david-schoe/mcmb/root_mcmb_pcb_files/root_pcb_3d_models/root_usr_es1_ethernet_tiago_silva/USR-ES1 Ethernet Module.PNG

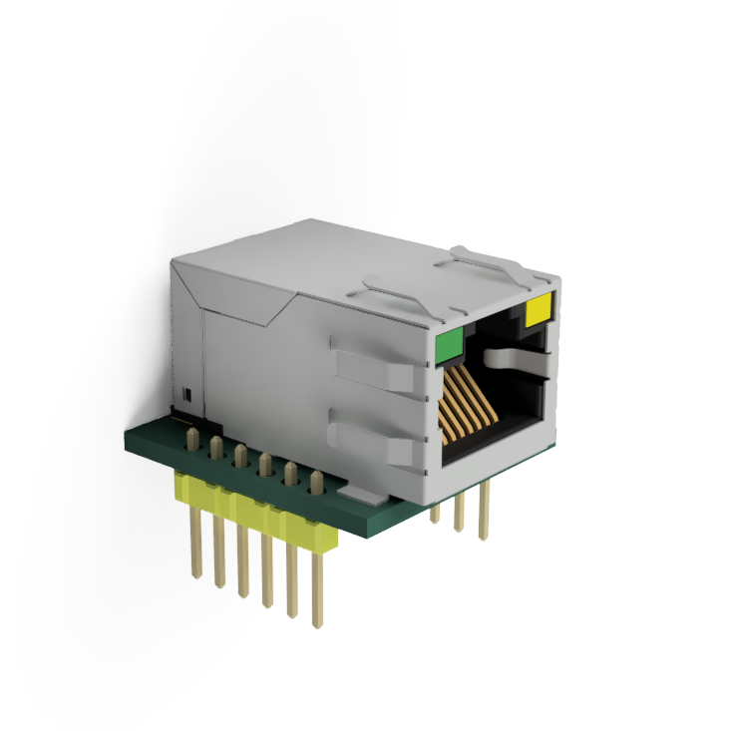
root_mcmb_pcb_files/root_pcb_3d_models/root_usr_es1_ethernet_tiago_silva/USR-ES1 Ethernet Module.PNG
