david-schoe/mcmb/root_mcmb_pcb_files/root_pcb_3d_models/root_enclosure/din_clip.stp

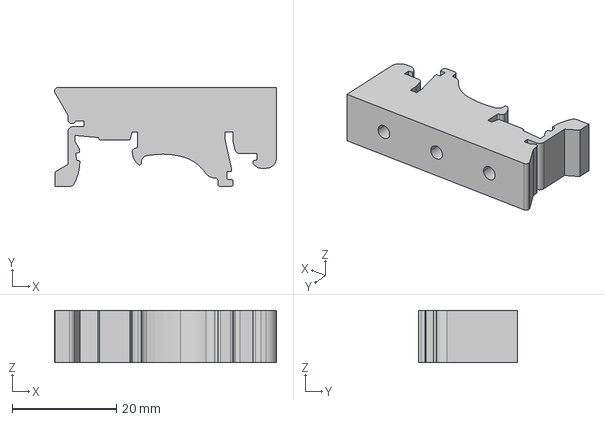
[picture p2: CAD file, 2025-05-01]
root_mcmb_pcb_files/root_pcb_3d_models/root_enclosure/din_clip.stp
42.6 x 19.0 x 10.0 mm
