david-schoe/mcmb/root_mcmb_pcb_files/root_pcb_3d_models/root_esp32_ch340_pennel_patrice/esp32_wroom_32D_kitV1_wph.step

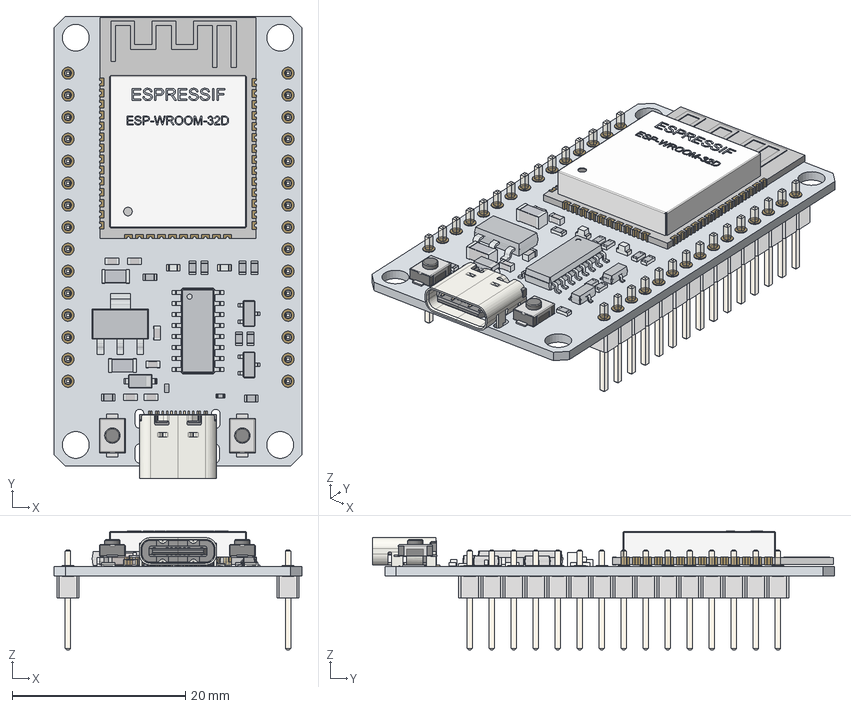
[picture p3: CAD file, 2025-05-01]
root_mcmb_pcb_files/root_pcb_3d_models/root_esp32_ch340_pennel_patrice/esp32_wroom_32D_kitV1_wph.step
28.6 x 53.3 x 13.7 mm
PCB
SOIC_16_39x99mm_P127mm
SOT_223
USB_C_Receptacle_16P_TopMnt_Horizontal_GCT_USB4105-xx-A
USB_C_Receptacle_16P_TopMnt_Horizontal_GCT_USB4105-xx-A001
USB_C_Receptacle_16P_TopMnt_Horizontal_GCT_USB4105-xx-A002
USB_C_Receptacle_16P_TopMnt_Horizontal_GCT_USB4105-xx-A003
USB_C_Receptacle_16P_TopMnt_Horizontal_GCT_USB4105-xx-A004
USB_C_Receptacle_16P_TopMnt_Horizontal_GCT_USB4105-xx-A005
USB_C_Receptacle_16P_TopMnt_Horizontal_GCT_USB4105-xx-A006
USB_C_Receptacle_16P_TopMnt_Horizontal_GCT_USB4105-xx-A007
USB_C_Receptacle_16P_TopMnt_Horizontal_GCT_USB4105-xx-A008
USB_C_Receptacle_16P_TopMnt_Horizontal_GCT_USB4105-xx-A009
USB_C_Receptacle_16P_TopMnt_Horizontal_GCT_USB4105-xx-A010
USB_C_Receptacle_16P_TopMnt_Horizontal_GCT_USB4105-xx-A011
USB_C_Receptacle_16P_TopMnt_Horizontal_GCT_USB4105-xx-A012
USB_C_Receptacle_16P_TopMnt_Horizontal_GCT_USB4105-xx-A013
USB_C_Receptacle_16P_TopMnt_Horizontal_GCT_USB4105-xx-A014
USB_C_Receptacle_16P_TopMnt_Horizontal_GCT_USB4105-xx-A015
USB_C_Receptacle_16P_TopMnt_Horizontal_GCT_USB4105-xx-A016
USB_C_Receptacle_16P_TopMnt_Horizontal_GCT_USB4105-xx-A017
USB_C_Receptacle_16P_TopMnt_Horizontal_GCT_USB4105-xx-A018
USB_C_Receptacle_16P_TopMnt_Horizontal_GCT_USB4105-xx-A019
USB_C_Receptacle_16P_TopMnt_Horizontal_GCT_USB4105-xx-A020
USB_C_Receptacle_16P_TopMnt_Horizontal_GCT_USB4105-xx-A021
USB_C_Receptacle_16P_TopMnt_Horizontal_GCT_USB4105-xx-A022
USB_C_Receptacle_16P_TopMnt_Horizontal_GCT_USB4105-xx-A023
USB_C_Receptacle_16P_TopMnt_Horizontal_GCT_USB4105-xx-A024
USB_C_Receptacle_16P_TopMnt_Horizontal_GCT_USB4105-xx-A025
USB_C_Receptacle_16P_TopMnt_Horizontal_GCT_USB4105-xx-A026
USB_C_Receptacle_16P_TopMnt_Horizontal_GCT_USB4105-xx-A027
USB_C_Receptacle_16P_TopMnt_Horizontal_GCT_USB4105-xx-A028
USB_C_Receptacle_16P_TopMnt_Horizontal_GCT_USB4105-xx-A029
USB_C_Receptacle_16P_TopMnt_Horizontal_GCT_USB4105-xx-A030
USB_C_Receptacle_16P_TopMnt_Horizontal_GCT_USB4105-xx-A031
USB_C_Receptacle_16P_TopMnt_Horizontal_GCT_USB4105-xx-A032
USB_C_Receptacle_16P_TopMnt_Horizontal_GCT_USB4105-xx-A033
USB_C_Receptacle_16P_TopMnt_Horizontal_GCT_USB4105-xx-A034
USB_C_Receptacle_16P_TopMnt_Horizontal_GCT_USB4105-xx-A035
LED_0603_D2
LED_0603_PWR
SOT_23_1
SOT_23_002
D_SOD_123
R_0603_
R_0603_001
R_0603_002
R_0603_003
R_0603_004
R_0603_005
R_0603_006
R_0603_007
R_0402_001
R_0402_002
R_0603_008
C_0603_
C_0603_001
C_0603_002
C_0603_003
C_0603_004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
