david-schoe/mcmb/root_mcmb_pcb_files/root_pcb_3d_models/root_power_supply/TMH2405S.step

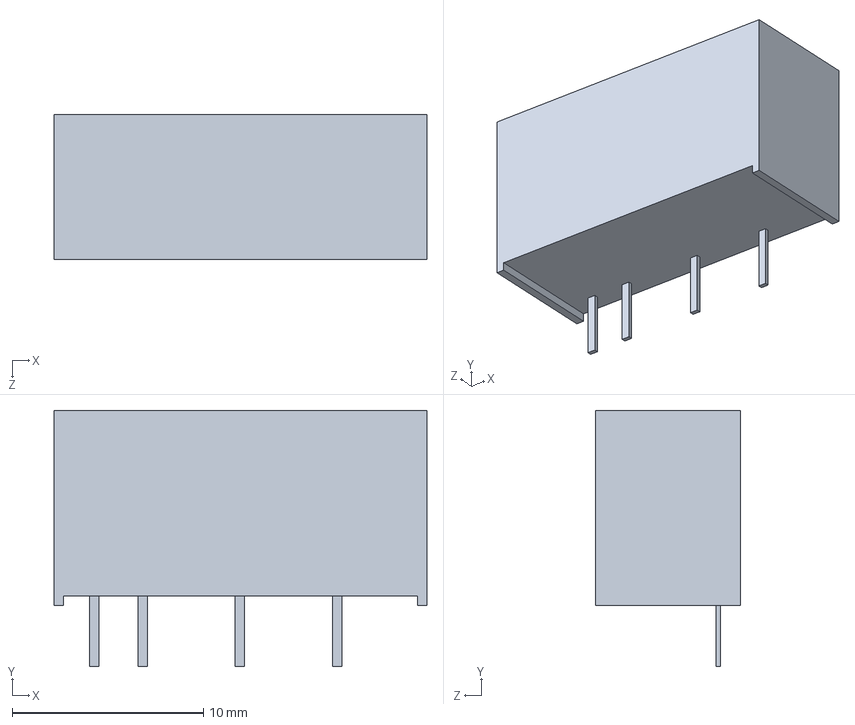
[picture p4: CAD file, 2025-05-01]
root_mcmb_pcb_files/root_pcb_3d_models/root_power_supply/TMH2405S.step
19.5 x 13.4 x 7.60 mm
