david-schoe/mcmb/root_mcmb_pcb_files/root_pcb_3d_models/root_terminals/header+connector.step

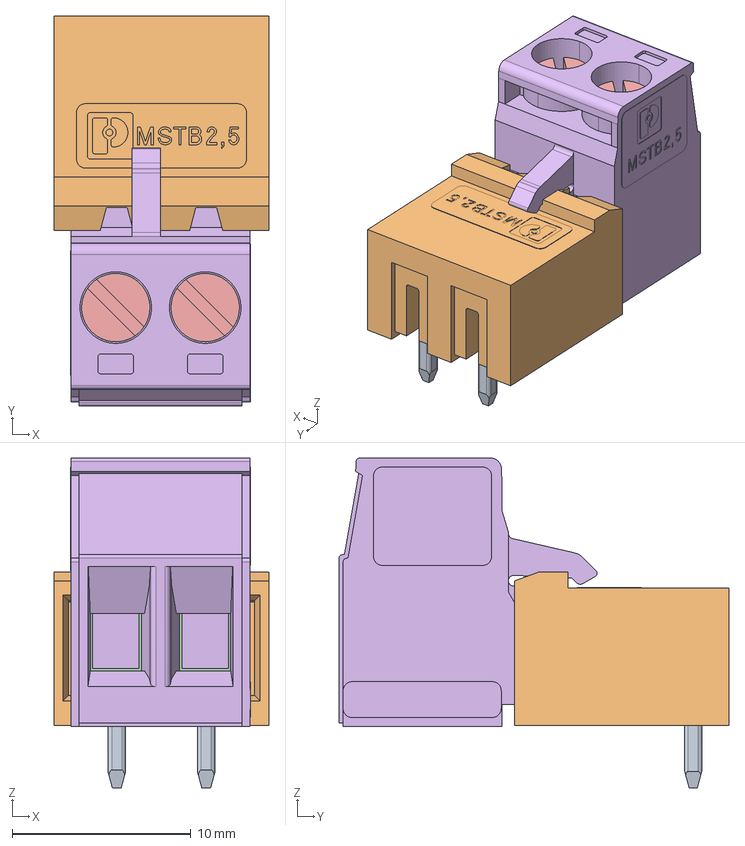
[picture p5: CAD file, 2025-05-01]
root_mcmb_pcb_files/root_pcb_3d_models/root_terminals/header+connector.step
12.0 x 21.8 x 18.4 mm
