david-schoe/mcmb/root_mcmb_pcb_files/root_pcb_3d_models/root_terminals/header/header.FCStd

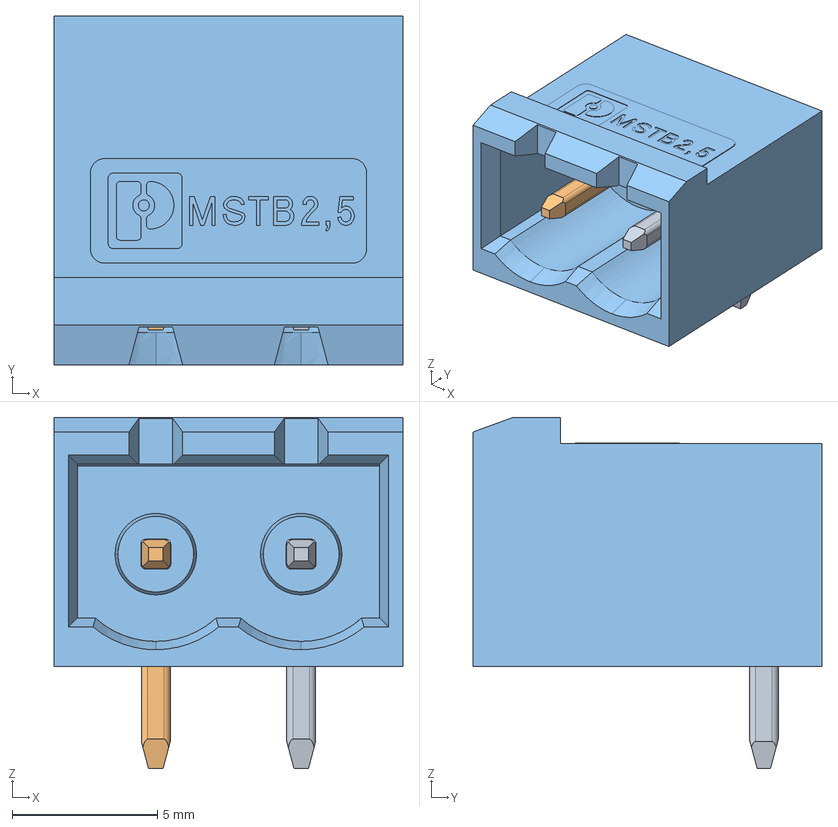
[picture p6: CAD file, 2025-05-01]
root_mcmb_pcb_files/root_pcb_3d_models/root_terminals/header/header.FCStd
12.0 x 12.0 x 12.1 mm
