david-schoe/mcmb/root_mcmb_pcb_files/root_pcb_3d_models/root_txrx/root_txrx0.step

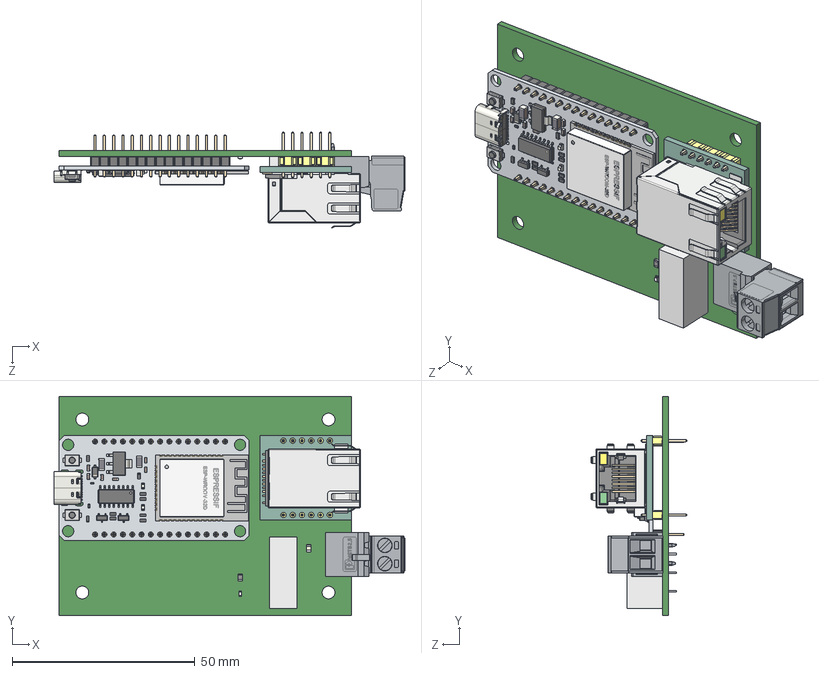
[picture p7: CAD file, 2025-05-01]
root_mcmb_pcb_files/root_pcb_3d_models/root_txrx/root_txrx0.step
96.0 x 60.0 x 26.4 mm
Board_root_txrx0
CAP_0805_M
150060SS75000
header+connector
TMH2405S
RES_0805_M
esp32_wroom_32D_kitV1_wph
USR-ES1_Ethernet_Module
