david-schoe/mcmb/root_mcmb_pcb_files/root_pcb_3d_models/root_usr_es1_ethernet_tiago_silva/USR-ES1 Ethernet Module.step

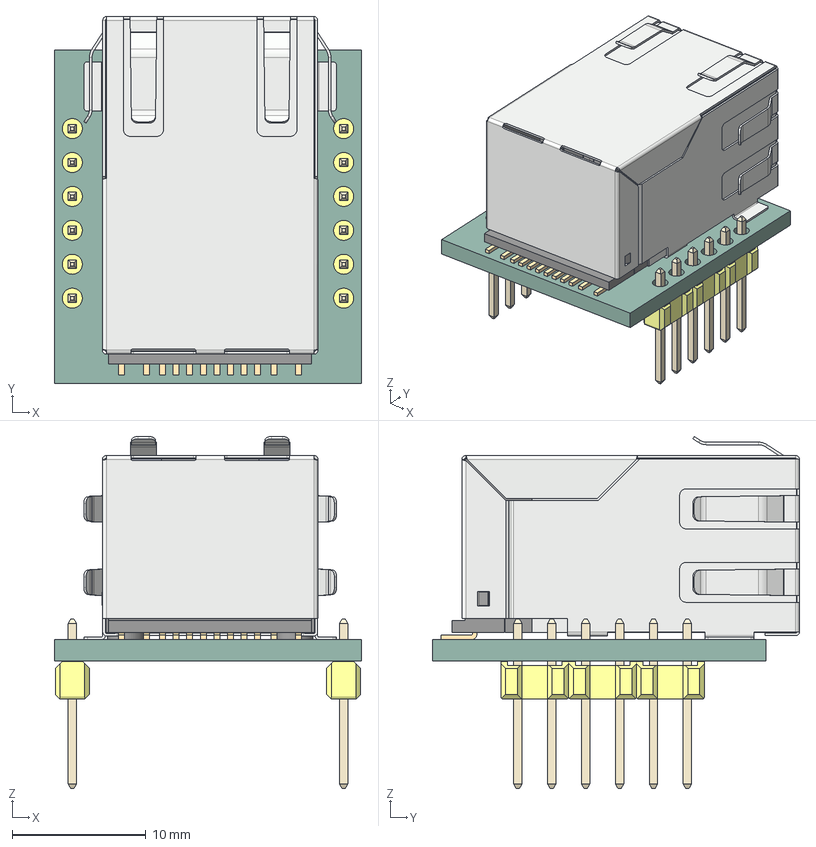
[picture p8: CAD file, 2025-05-01]
root_mcmb_pcb_files/root_pcb_3d_models/root_usr_es1_ethernet_tiago_silva/USR-ES1 Ethernet Module.step
23.0 x 27.5 x 26.4 mm
Pin Header 2x1 TH Pitch 2.54mm x 7
2pin-LED_1_1
P-¡T+L-7Pin-AA
P-¡T+L-5Pin-AA
led1
1X1RJ45-housing_-¦L¡
