david-schoe/mcmb/root_mcmb_pcb_files/root_pcb_3d_models/root_enclosure/enclosure2.FCStd

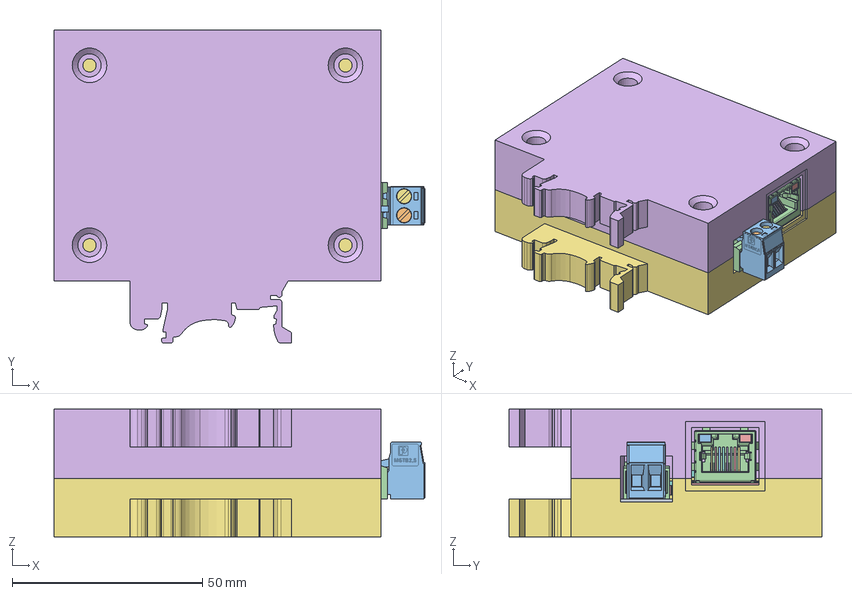
[picture p9: CAD file, 2025-05-01]
root_mcmb_pcb_files/root_pcb_3d_models/root_enclosure/enclosure2.FCStd
97.6 x 82.4 x 33.6 mm
Board_root_txrx0
CAP_0805_M
CAP_0805_M001
CAP_0805_M002
150060SS75000
150060SS75001
150060SS75002
150060SS75003
150060SS75004
header+connector
header+connector001
header+connector002
header+connector003
header+connector004
header+connector005
header+connector006
header+connector007
header+connector008
header+connector009
TMH2405S
RES_0805_M
RES_0805_M001
RES_0805_M002
esp32_wroom_32D_kitV1_wph
esp32_wroom_32D_kitV1_wph001
esp32_wroom_32D_kitV1_wph002
esp32_wroom_32D_kitV1_wph003
esp32_wroom_32D_kitV1_wph004
esp32_wroom_32D_kitV1_wph005
esp32_wroom_32D_kitV1_wph006
esp32_wroom_32D_kitV1_wph007
esp32_wroom_32D_kitV1_wph008
esp32_wroom_32D_kitV1_wph009
esp32_wroom_32D_kitV1_wph010
esp32_wroom_32D_kitV1_wph011
esp32_wroom_32D_kitV1_wph012
esp32_wroom_32D_kitV1_wph013
esp32_wroom_32D_kitV1_wph014
esp32_wroom_32D_kitV1_wph015
esp32_wroom_32D_kitV1_wph016
esp32_wroom_32D_kitV1_wph017
esp32_wroom_32D_kitV1_wph018
esp32_wroom_32D_kitV1_wph019
esp32_wroom_32D_kitV1_wph020
esp32_wroom_32D_kitV1_wph021
esp32_wroom_32D_kitV1_wph022
esp32_wroom_32D_kitV1_wph023
esp32_wroom_32D_kitV1_wph024
esp32_wroom_32D_kitV1_wph025
esp32_wroom_32D_kitV1_wph026
esp32_wroom_32D_kitV1_wph027
esp32_wroom_32D_kitV1_wph028
esp32_wroom_32D_kitV1_wph029
esp32_wroom_32D_kitV1_wph030
esp32_wroom_32D_kitV1_wph031
esp32_wroom_32D_kitV1_wph032
esp32_wroom_32D_kitV1_wph033
esp32_wroom_32D_kitV1_wph034
esp32_wroom_32D_kitV1_wph035
esp32_wroom_32D_kitV1_wph036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
