david-schoe/mcmb/root_mcmb_pcb_files/root_pcb_3d_models/root_terminals/connector/connector.FCStd

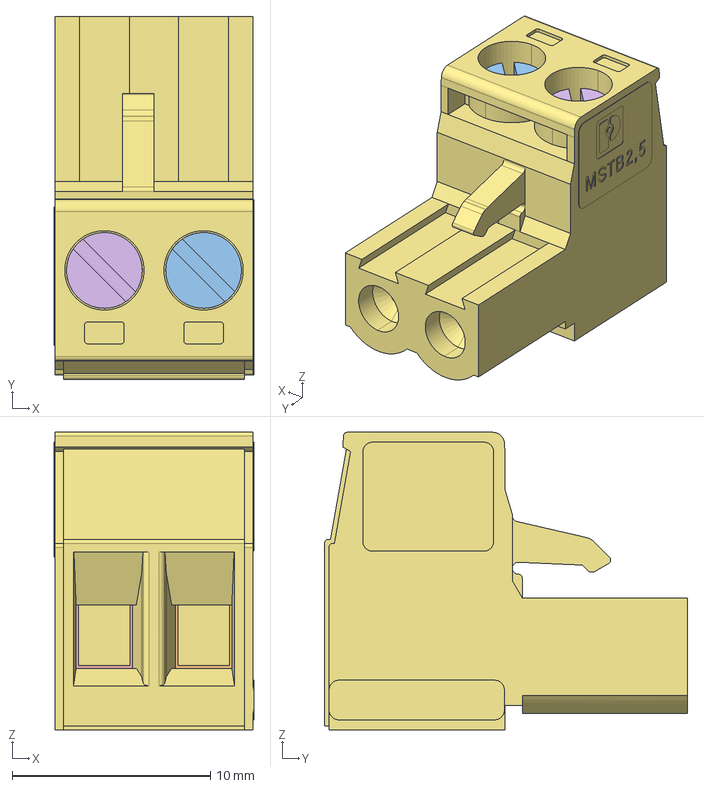
[picture p11: CAD file, 2025-05-01]
root_mcmb_pcb_files/root_pcb_3d_models/root_terminals/connector/connector.FCStd
10.1 x 18.3 x 15.0 mm
