david-schoe/mcmb/root_mcmb_pcb_files/root_pcb_3d_models/root_enclosure/bottom+din_clip.stl

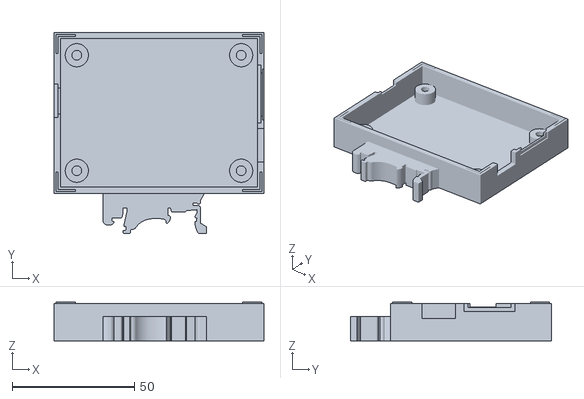
[picture p12: CAD file, 2025-05-01]
root_mcmb_pcb_files/root_pcb_3d_models/root_enclosure/bottom+din_clip.stl
86.0 x 82.4 x 15.9
