david-schoe/mcmb/root_mcmb_pcb_files/root_pcb_3d_models/root_diodes/150060SS75000.step

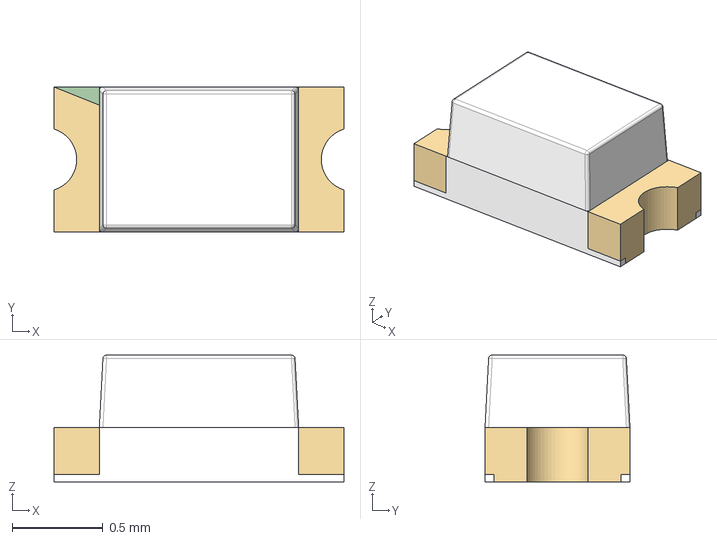
[picture p14: CAD file, 2025-05-01]
root_mcmb_pcb_files/root_pcb_3d_models/root_diodes/150060SS75000.step
1.60 x 0.8 x 0.7 mm
