david-schoe/mcmb/root_mcmb_pcb_files/root_pcb_3d_models/root_m3_screws/female_test_25.stl

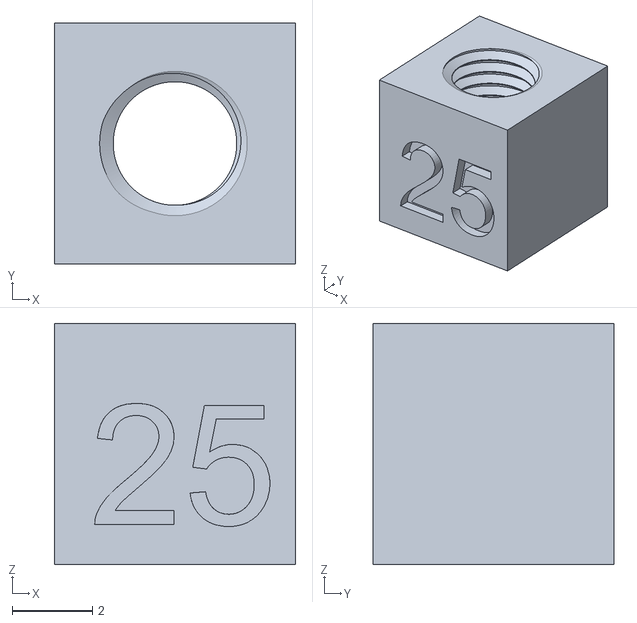
[picture p16: CAD file, 2025-05-01]
root_mcmb_pcb_files/root_pcb_3d_models/root_m3_screws/female_test_25.stl
6.00 x 6.00 x 6.00
