david-schoe/mcmb/(list of files, cad)

Other CAD files:
root_mcmb_pcb_files/root_pcb_3d_models/root_terminals/connector/1754449.stp
root_mcmb_pcb_files/root_pcb_3d_models/root_terminals/header/1757475.stp
root_mcmb_pcb_files/root_pcb_3d_models/root_m3_screws/female_test_06.stl
root_mcmb_pcb_files/root_pcb_3d_models/root_esp32_ch340_pennel_patrice/esp32_wroom_32D_kitV1.FCStd
root_mcmb_pcb_files/root_pcb_3d_models/root_esp32_ch340_pennel_patrice/esp32_wroom_32D_kitV1_wph.FCStd
root_mcmb_pcb_files/root_pcb_3d_models/root_m3_screws/92000A118_Passivated 18-8 Stainless Steel Pan Head Phillips Screws.STEP
root_mcmb_pcb_files/root_pcb_3d_models/root_m3_screws/female_block.FCStd
root_mcmb_pcb_files/root_pcb_3d_models/root_m3_screws/female_test.FCStd
root_mcmb_pcb_files/root_pcb_3d_models/root_m3_screws/female_test.stl
root_mcmb_pcb_files/root_pcb_3d_models/root_m3_screws/female_test_05.stl
root_mcmb_pcb_files/root_pcb_3d_models/root_m3_screws/female_test_07.stl
root_mcmb_pcb_files/root_pcb_3d_models/root_m3_screws/female_test_08.stl
root_mcmb_pcb_files/root_pcb_3d_models/root_m3_screws/female_test_09.stl
root_mcmb_pcb_files/root_pcb_3d_models/root_m3_screws/female_test_15.stl
root_mcmb_pcb_files/root_pcb_3d_models/root_m3_screws/female_test_20.stl
root_mcmb_pcb_files/root_pcb_3d_models/root_terminals/header+connector.FCStd
