david-schoe/mcmb/root_mcmb_pcb_files/user-manual.docx

System Overview

Purpose of TX and RX devices:

Note: To begin with, TX and RX are identical devices both in hardware and in software. At the start of the project, labeling the devices TX and RX was thought a good idea, but as the project developed, the distinction between the two devices lessened. TX will refer to the device that (for this application) is to be connected to the HMI and RX will refer to the device that (for this application) is to be connected to the DAT-8024.

TX serves as a reading and writing link between TCP Modbus compatible devices. It can read four registers from any four connected devices, and write the respective register values to any four registers on any four connected devices. The external TCP Modbus devices may connect to TX/RX using ANY of the network interfaces. Additionally, since the register values will typically correspond to a real signal (i.e. 4-20mA), and given that not every Modbus device will represent any given signal using the same digital values, TX is capable of applying linear interpolation to a read register value before writing the register value. This is best understood with an example:

Let TX be connected to two TCP Modbus devices over the ethernet connection (this is a possible setup if TX is connected to an ethernet switch, and the switch connects two external TCP Modbus devices). Let the devices be e0 and e1. TX reads a single register from e0 and writes it to e1. The register being read on e0 is storing a 4-20mA signal with 16-bit precision, thus a register value of 0x0000 corresponds to 4mA and a register value of 0xFFFF corresponds to 20mA. The register being written to on e1 is storing a 0-20mA signal with 12-bit precision, thus a register value of 0x0000 corresponds to 0mA and a register value of 0x0FFF corresponds to 20mA. It is clear from this setup that the value read from e0 cannot be simply written to e1, as the analog signal would not be correctly preserved. Therefore, a linear interpolation rule is always applied to the register value read before writing the register value. To ensure the analog signal is preserved:

the low value of the read register should be 0x0000 (this corresponds to 4mA on e0);

the high value of the read register should be 0xFFFF (this corresponds to 20mA on e0);

the low value of the write register should be 0x0333 (this corresponds to 4mA on e1);

the high value of the write register should be 0x0FFF (this corresponds to 20mA on e1);

TX/RX has three network interfaces: eth, wlan0 (WIFI AP) and wlan1 (WIFI STA). It has port forwarding enabled so any messages received on one subnet that are intended for another subnet will be routed to the interface that corresponds to the subnet (if and only if there is an interface configured that is in the subnet of the received packet). TX utilizes an esp32 to make all networking possible, and is limited to the esp32’s networking hierarchy. As such, no routing tables may be explicitly defined. However, with careful utilization of gateway’s, netmask’s and binding addresses, TX is capable of handling significant networking tasks.

Block diagram and signal flow:

Read external or local register
Write to external or local register
Apply interpolation

Hardware Setup

PCB Assembly:

1. Solder the PCB according to “pcb_layout” and “pcb_schematic”
  a. Note: Diode polarity is indicated on the board matching marking on the bottom of the diode
2. Solder a jumper between D35 and D26
  a. This is a wire edit that can be updated in future rev. D35 is an input only pin that must be used as an output thus a jumper is needed

Enclosure Assembly:

1. Slice and print both “bottom+din_clip.stl” and “top+din_clip.stl” being sure to add supports for the overhangs that are present in “top+din_clip.stl” on the screw posts.
2. Install the heat fitted M3 threads into the posts on the bottom of the enclosure.
3. Secure the top and bottom enclosure pieces together with 4 M3 screws.

Software Setup

1. Refer to the documentation here: https://docs.espressif.com/projects/esp-idf/en/latest/esp32/get-started/index.html to setup esp-idf on any OS.
2. Modify your/path/to/esp-idf/components/lwip/lwip/src/core:513 to be "if (force || IP_FORWARD) {"
3. Navigate into mcmb/TXRX
4. Execute idf.py build
5. Execute idf.py flash

Webserver Configuration

Access configuration menu for TX/RX/DAT-8024:

1. Connect to TX/RX wifi ap specified by ssid (default “192.168.2.1”) with any device.
2. Type the TX/RX/dat-8024 ip4 address in the dns address bar of browser on your connected device.

Note: If trying to access dat-8024 config, the dat-8024 must be powered on and connected to RX. Additionally, RX’s ap gw must be set with RX’s ap ip4.

3. Adjust network settings as needed

TX/RX/DAT-8024 configuration:

1. TX/RX's eth/ap/sta ip4 and dat-8024’s ip4 must be unique ip4 addresses
2. eth ip4 must be in a different subnet than ap/sta ip4 on TX/RX
3. RX's eth ip4 and dat-8024's ip4 must be in the same subnet
4. dat-8024’s gw must be set to RX’s eth ip4
5. every netif must have a valid ip4 as it's gw and every netif must have a valid nm
6. TX's sta gw must be set with RX's ap ip4
7. RX’s ap gw must be set with RX’s ap ip4
8. All of TX’s “low value”s should be set to the smallest value that can be read/written and “high value”s the largest that can be read/written. (See the example given in “System Overview”)
9. !!! pay careful attention to the subnets being properly differentiated by each netif's nm !!!

Troubleshooting

Hierarchy:

1. Restart the devices
2. Check to ensure all steps listed in “Bare minimum TX/RX/DAT-8024 config for proper function” are upheld.
3. Ensure that “low value” and “high value” are properly configured to account for discrepancies of storing analog signals digitally.
4. Check the serial output of TX/RX by connecting using usb-c port to a computer (computer with esp-idf setup) and typing “idf.py monitor”.
