david-schoe/mcmb/(list of files, drawings)

Other design files:
root_mcmb_pcb_files/root_pcb_layout.dip
root_mcmb_pcb_files/root_pcb_schematic.dch
