david-schoe/mcmb/txrx/components/include/esp.h

#ifndef ESP_H
#define ESP_H

#include <string.h>
#include <stdio.h>
#include "esp_netif.h"
#include "esp_eth_netif_glue.h"
#include "driver/gpio.h"
#include "esp_eth_mac_spi.h"
#include "esp_eth_phy.h"
#include "esp_mac.h"
#include "lwip/ip4_addr.h"
#include "freertos/FreeRTOS.h"
#include "freertos/task.h"
#include "esp_wifi.h"
#include "esp_event.h"
#include "esp_log.h"
#include "lwip/err.h"
#include "lwip/sys.h"
#include "nvs_flash.h"
#include "esp_http_server.h"

#endif
